bdubs-astro/enclosure_w_snap_fit_lid_v2/logos/OSHW-logos/OSHW_logo.dxf

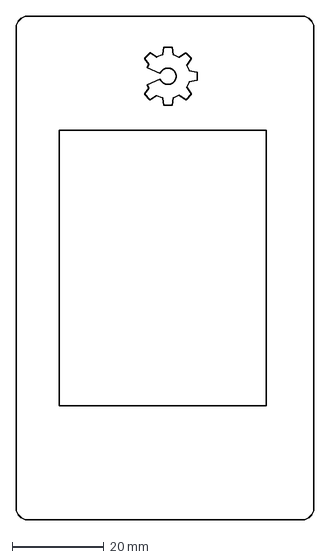
[picture p3: CAD file, 2026-11-09]
logos/OSHW-logos/OSHW_logo.dxf
65.0 x 110.0 mm
