bdubs-astro/enclosure_w_snap_fit_lid_v2/(list of files, cad)

Other CAD files:
codex snap-fit.f3d
